stanekTM/RX_nRF24L01_Telemetry_Motor_Servo/README.md

# RC receiver (motor-servo driver, telemetry)
RC receiver with fixed RF channel and fixed address.
Telemetry sends measured voltage and "fake" RSSI (the nRF24L01+ transceiver does not contain real RSSI and is only a rough measurement of lost packets).

The hardware includes nRF24L01+ transceiver and ATmega328P processor.
The motor driver IC is based on MX1208, MX1508, MX1515, MX1616, MX1919 and others similar, which uses 4x PWM input control signals.
The option to adjust the brake is included in the code.

The firmware will be used for cars, boats, tanks, robots and aircraft.

**Works with RC transmitters:**
* [**TX_nRF24_2ch_OLED**](https://github.com/stanekTM/TX_nRF24_2ch_OLED)
* [**TX_nRF24_5ch_LED**](https://github.com/stanekTM/TX_nRF24_5ch_LED)
* [**OpenAVRc**](https://github.com/Ingwie/OpenAVRc_Dev)
* [**Multiprotocol**](https://github.com/stanekTM/TX_FW_Multi_Stanek) from my fork.

## Used libraries
* <RF24.h>      https://github.com/nRF24/RF24
* <DigitalIO.h> https://github.com/greiman/DigitalIO
* <Servo.h>     Arduino standard library

## Micro RC receiver [(motor driver, telemetry)](https://github.com/stanekTM/RX_nRF24_Motor_Servo/tree/master/RX_OAVRc_Multi_2ch_Motor)
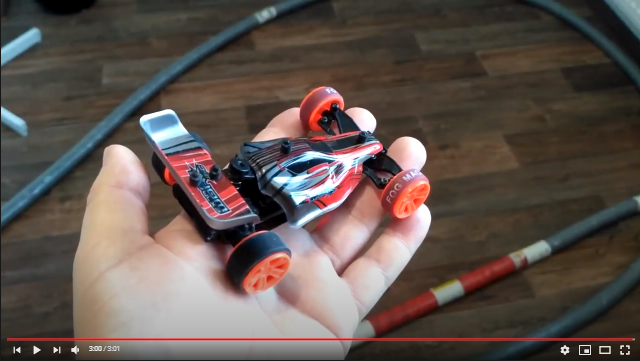
[picture p1: documents/micro_rx_youtube.PNG]


[The schematic](https://raw.githubusercontent.com/stanekTM/RX_nRF24_Motor_Servo/master/documents/micro_rx_schema.PNG) and [PCB](https://raw.githubusercontent.com/stanekTM/RX_nRF24_Motor_Servo/master/documents/micro_rx_layout.PNG) is created by a custom version of the open source [PCB Elegance](https://github.com/stanekTM/PCB_Elegance) and manufactured by [JLCPCB](https://jlcpcb.com)

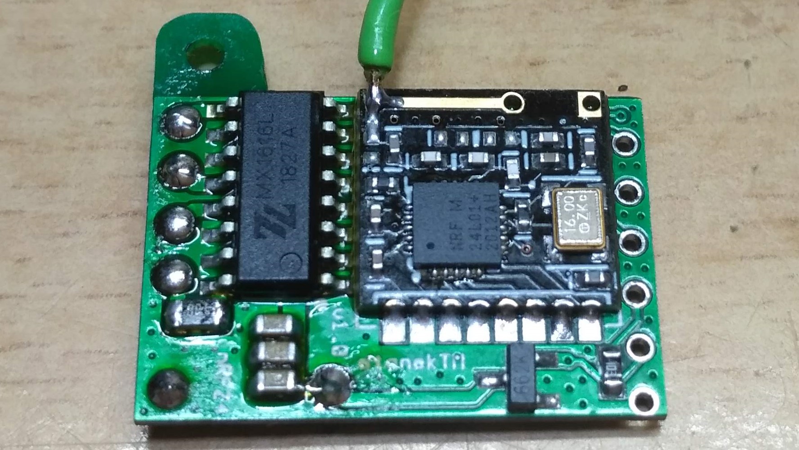
[picture p2: documents/micro_rx_1.jpg]
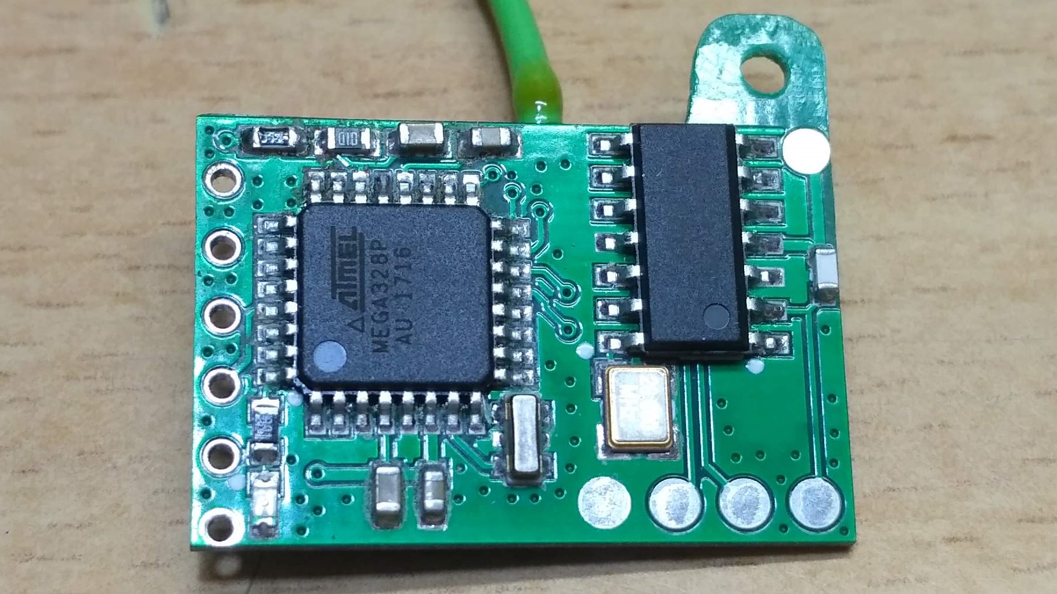
[picture p3: documents/micro_rx_2.jpg]

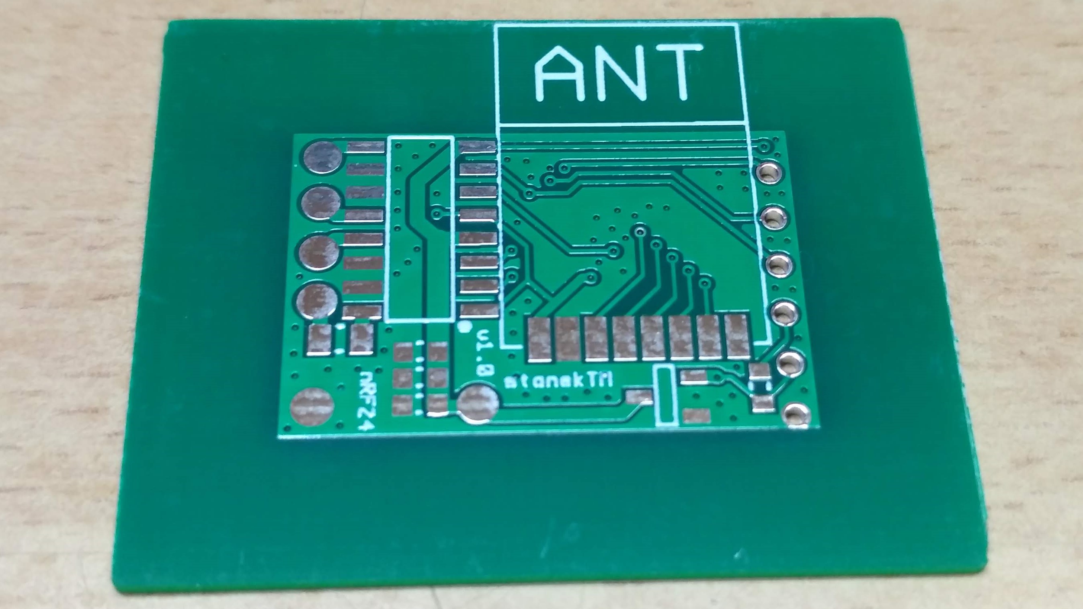
[picture p4: documents/micro_rx_3.jpg]
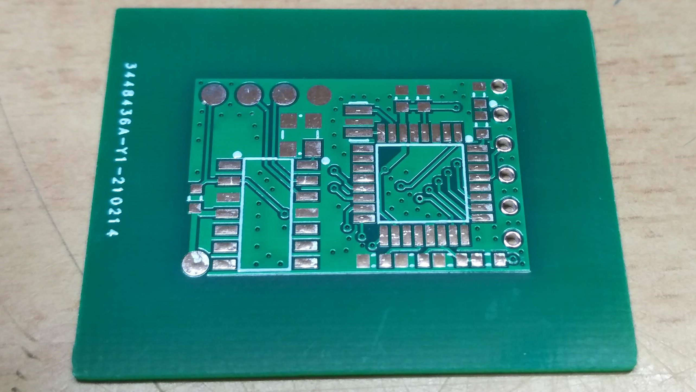
[picture p5: documents/micro_rx_4.jpg]

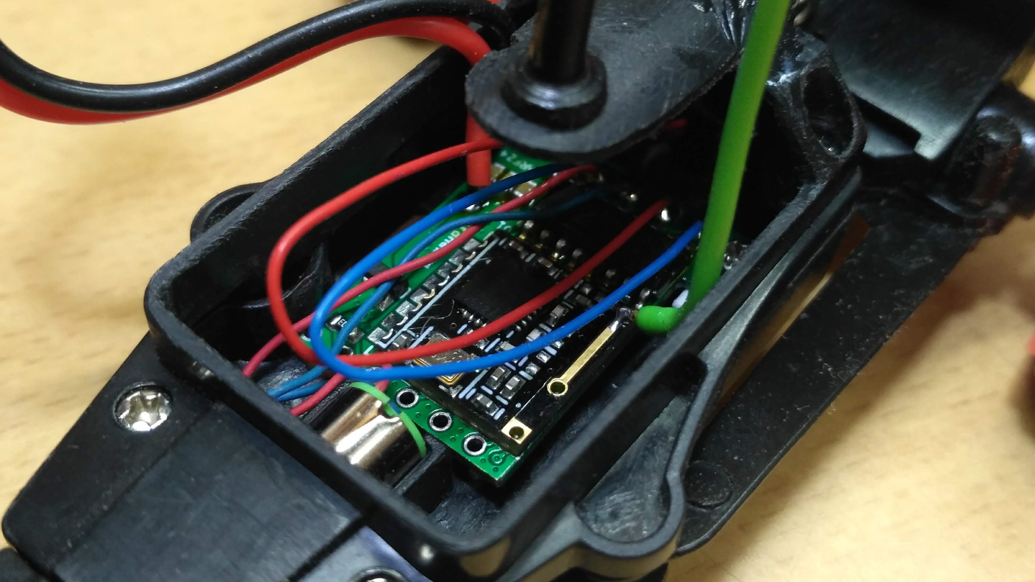
[picture p6: documents/micro_rx_5.jpg]
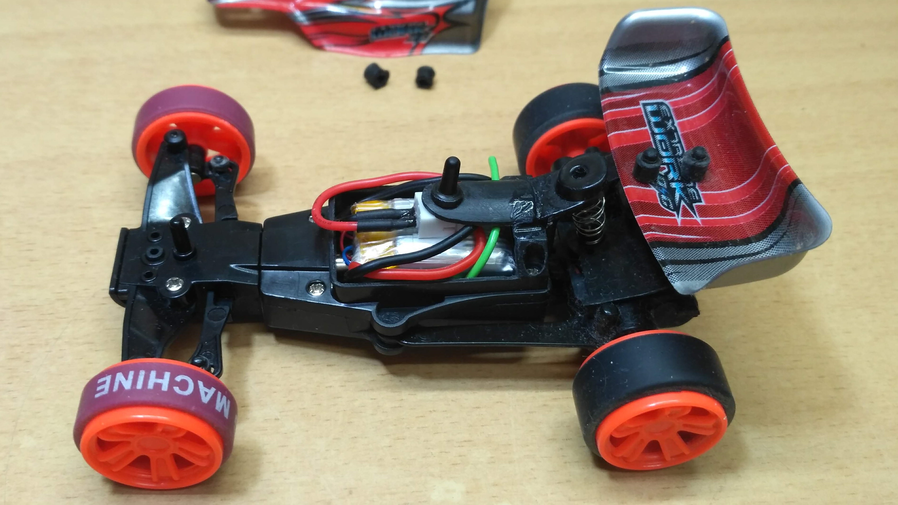
[picture p7: documents/micro_rx_6.jpg]

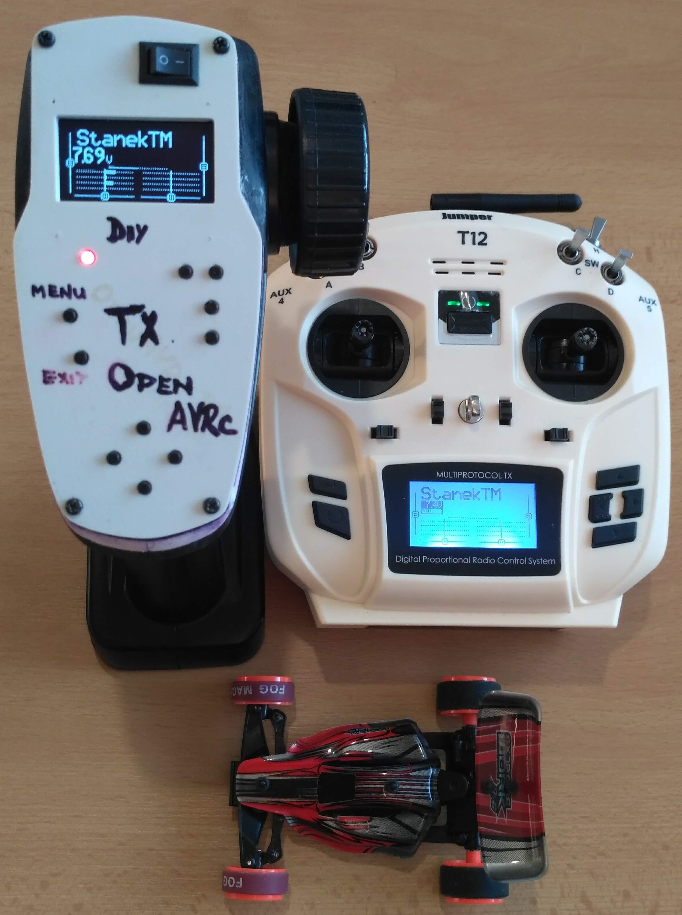
[picture p8: documents/micro_rx_7.jpg]


## RC receiver prototype [(motor-servo driver, telemetry)](https://youtu.be/jPN5YdQ-3K0?si=AT5yUzox_M3fIWEb)
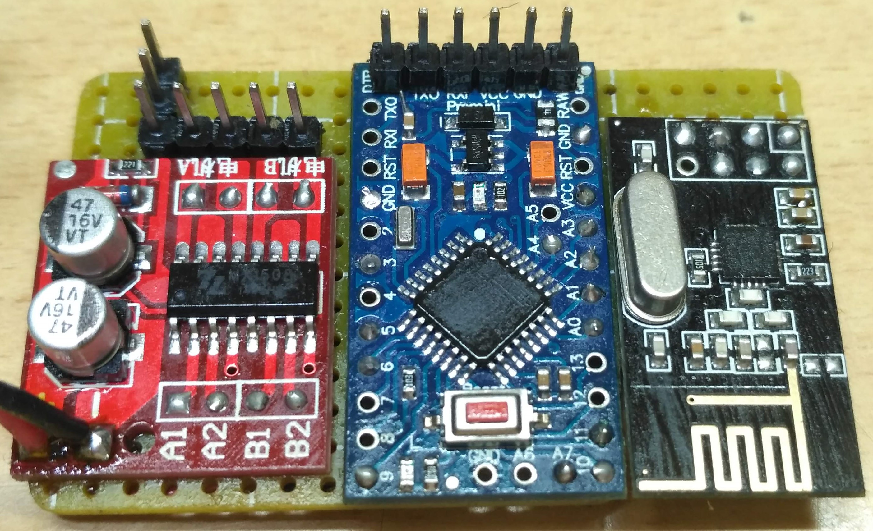
[picture p9: documents/rx_prototype_motor_servo_1.jpg]
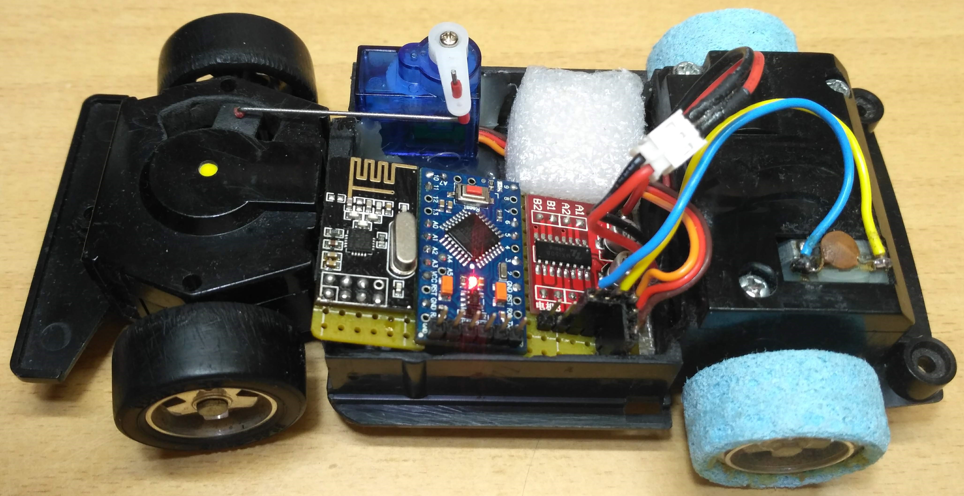
[picture p10: documents/rx_prototype_motor_servo_2.jpg]


## RC receiver prototype [(mix tank-arcade motor driver, telemetry)](https://github.com/stanekTM/RX_nRF24_Motor_Servo/tree/master/RX_nRF24_2ch_Motor_Mix_Tank)
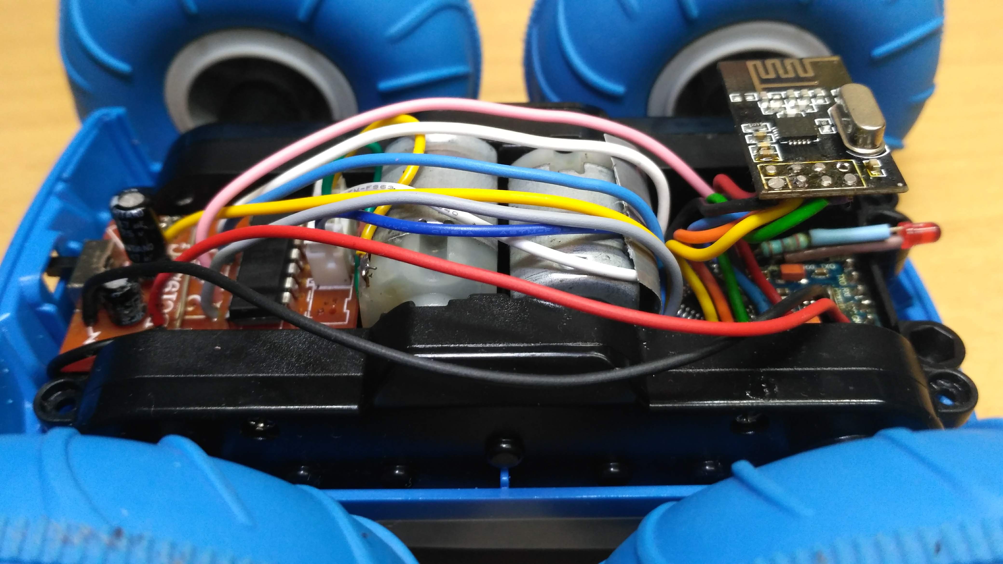
[picture p11: documents/rx_prototype_mix_tank_arcade_1.jpg]
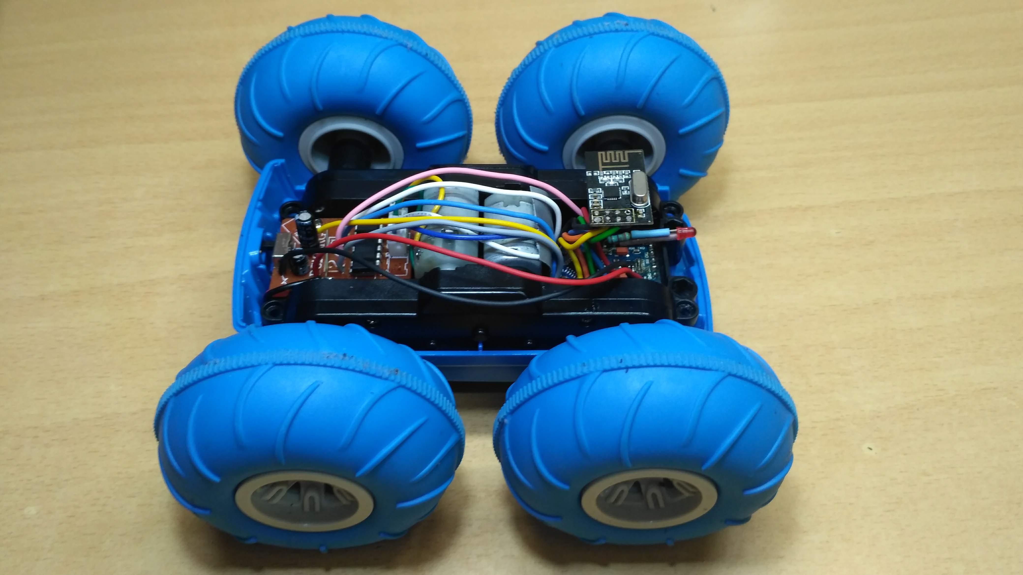
[picture p12: documents/rx_prototype_mix_tank_arcade_2.jpg]
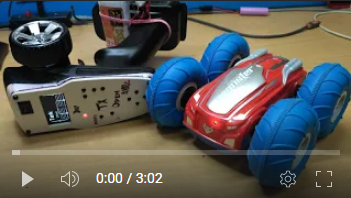
[picture p13: documents/rx_prototype_mix_tank_arcade_youtube.PNG]
