stanekTM/RX_nRF24L01_Telemetry_Motor_Servo/RX_OAVRc_Multi_2ch_Motor/README.md

# RC receiver 2ch (motor driver, telemetry)
Includes nRF24L01+ transceiver and ATmega328P processor.
The motor driver IC is based on MX1208, MX1508, MX1515, MX1616, MX1919 and others similar, which uses 4x PWM input control signals.
The option to adjust the brake is included in the code.
The PCB also includes a CMT2150A transponder for a custom RF lap reader.

The firmware will be used for cars.

Works with RC transmitters [**OpenAVRc**](https://github.com/Ingwie/OpenAVRc_Dev) or [**Multiprotocol**](https://github.com/stanekTM/TX_FW_Multi_Stanek) from my fork.

## Function
* MotorA = adjustable pwm/ch1
* MotorB = adjustable pwm/ch2
* Brake = on, off or adjustable effect 
* Normal mode = LED RX is lit
* Battery voltage 1S LiPo (4.2V) < monitored voltage = RX LED flash at a interval of 0.5s
* TX transmitter off or signal loss = RX LED flash at a interval of 0.1s 
* Fail-safe = MotorA and MotorB stopped

## Arduino pins
```
D9  - pwm1/MotorA
D10 - pwm2/MotorA
D3  - pwm3/MotorB
D11 - pwm4/MotorB

D2  - LED
A7  - telemetry analog input RX battery

nRF24L01+:
A0  - CE
A1  - CSN
software SPI:
A2  - SCK
A3  - MOSI
A4  - MISO
```

## Used libraries
* <RF24.h>      https://github.com/nRF24/RF24
* <DigitalIO.h> https://github.com/greiman/DigitalIO

## Example micro RX


The PCB is created by a custom version of the open source [PCB Elegance](https://github.com/stanekTM/PCB_Elegance) and manufactured by [JLCPCB](https://jlcpcb.com)






## An example of a tank-arcade mixer for OpenAVRc and OpenTX
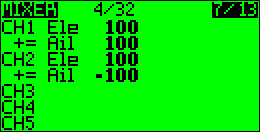
[picture p14: documents/example_mixer_1.bmp]
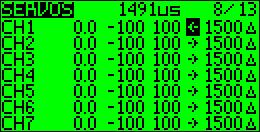
[picture p15: documents/example_mixer_2.bmp]


## Schema
The schematic is created by a custom version of the open source [PCB Elegance](https://github.com/stanekTM/PCB_Elegance)

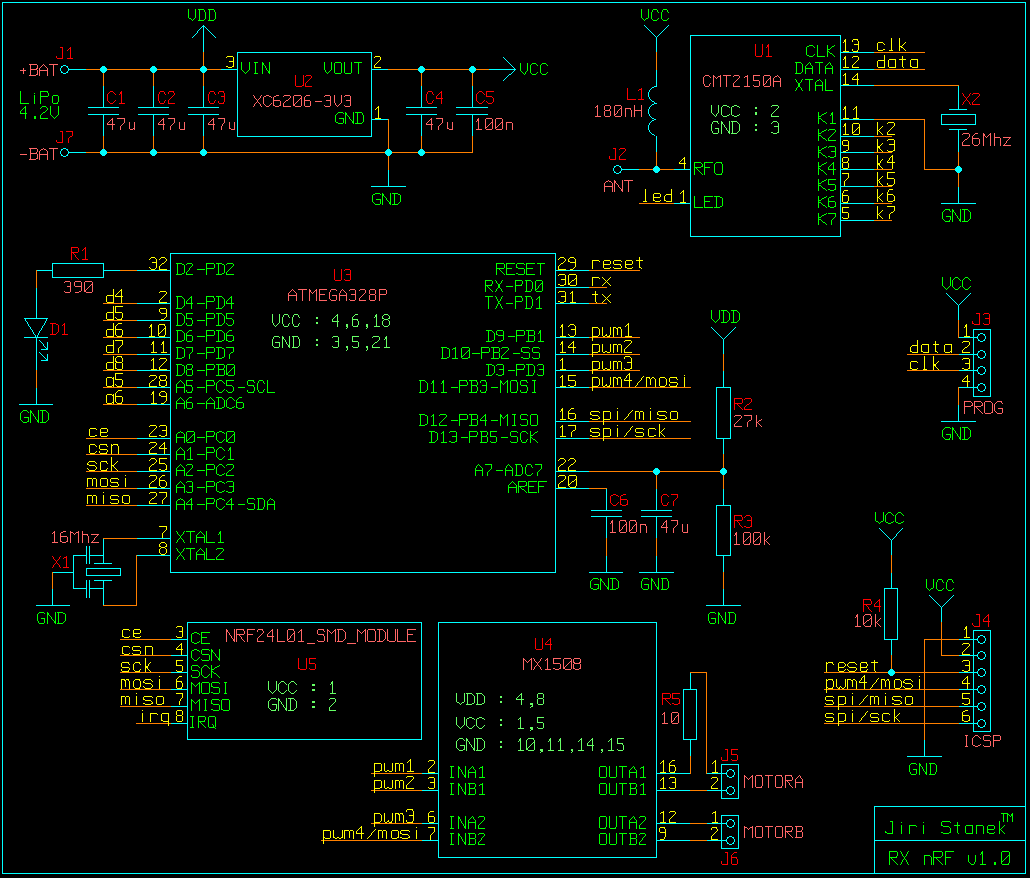
[picture p16: documents/micro_rx_schema.PNG]
schema


## Layout
The layout is created by a custom version of the open source [PCB Elegance](https://github.com/stanekTM/PCB_Elegance)

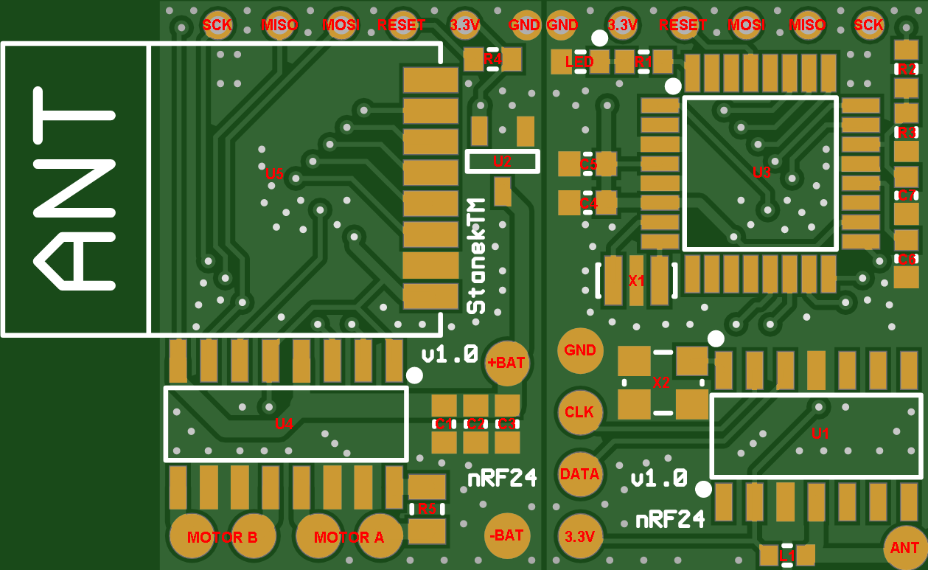
[picture p17: documents/micro_rx_layout.PNG]
layout
