stanekTM/RX_nRF24L01_Telemetry_Motor_Servo/documents/arduino_pro_mini_pinout.png

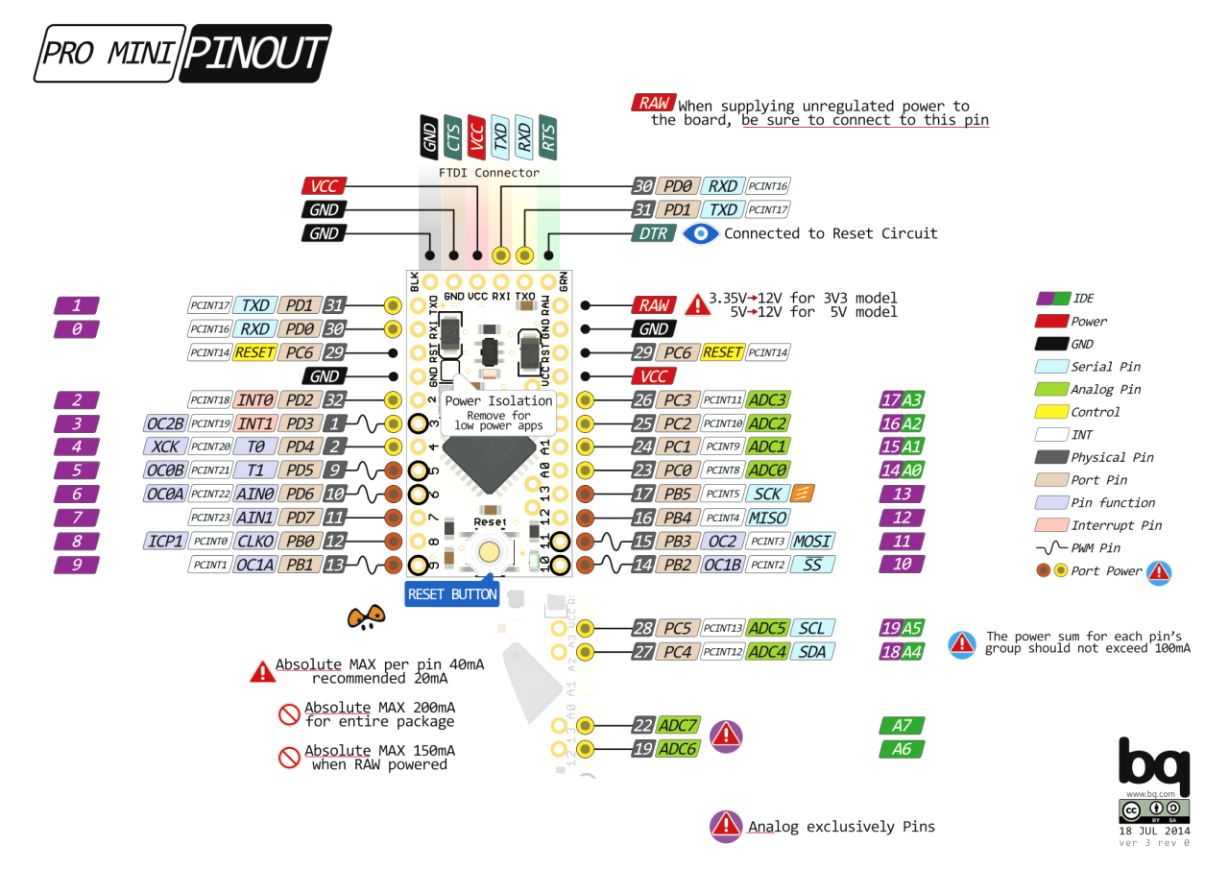
documents/arduino_pro_mini_pinout.png
