stanekTM/RX_nRF24L01_Telemetry_Motor_Servo/documents/nRF24L01_PA-LNA_external_antenna_module_pinout_top.png

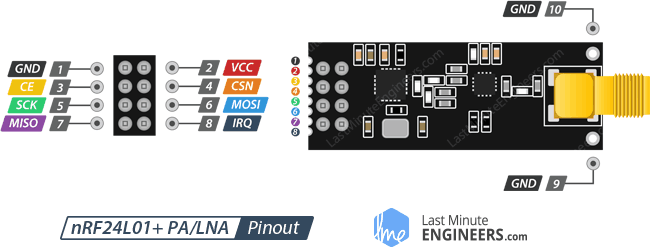
documents/nRF24L01_PA-LNA_external_antenna_module_pinout_top.png
