stanekTM/RX_nRF24L01_Telemetry_Motor_Servo/documents/nRF24L01_pcb_antenna_module_pinout_top-bottom.png

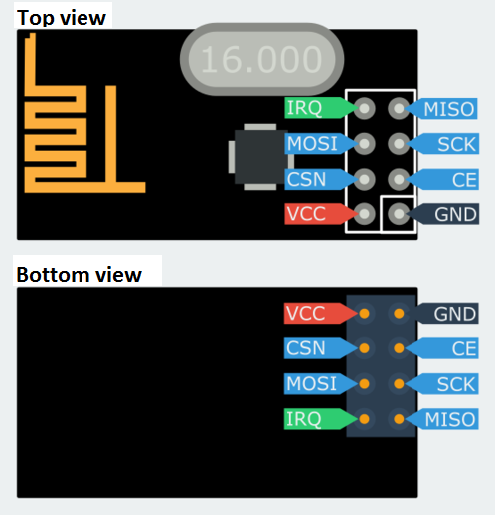
documents/nRF24L01_pcb_antenna_module_pinout_top-bottom.png
