stanekTM/RX_nRF24L01_Telemetry_Motor_Servo/documents/nRF24L01_smd_dimensions.PNG

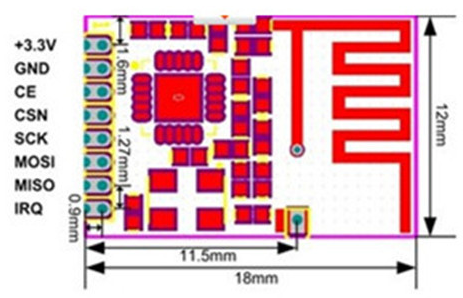
documents/nRF24L01_smd_dimensions.PNG
