stanekTM/RX_nRF24L01_Telemetry_Motor_Servo/documents/nRF24L01_smd_pinout_bottom.jpg

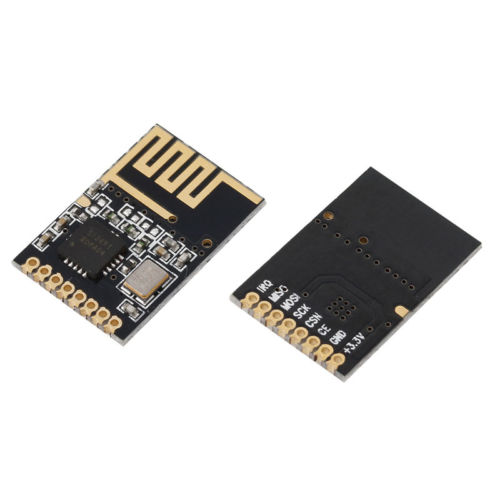
documents/nRF24L01_smd_pinout_bottom.jpg
