stanekTM/RX_nRF24L01_Telemetry_Motor_Servo/RC_RX_nRF24L01_2ch_A1_Motor_Driver/RC_RX_nRF24L01_2ch_A1_Motor_Driver.ino

//***************************************************************************************************
//Communication nRF24L01P. Fixed RF channel, fixed address.                                         *
//Support for TX Telemetry LCD transmitter https://github.com/stanekTM/RC_TX_nRF24L01_Telemetry_LCD *
//and for the TX Telemetry LED transmitter https://github.com/stanekTM/RC_TX_nRF24L01_Telemetry_LED *
//***************************************************************************************************

#include <RF24.h>         //https://github.com/nRF24/RF24 v1.3.9
//#include <printf.h>       //print the radio debug info
#include <DigitalIO.h>    //https://github.com/greiman/DigitalIO
#include "PWMFrequency.h" //used locally https://github.com/TheDIYGuy999/PWMFrequency


//setting RF channels address (5 bytes number or character)
const byte address[] = "jirka";

//RF communication channel settings (0-125, 2.4Ghz + 76 = 2.476Ghz)
#define radio_channel 76

//settings PWM MotorA (pin D9 or D10)
//1024 = 30Hz, 256 = 122Hz, 64 = 488Hz(default), 8 = 3906Hz
#define pwm_motorA 256

//settings PWM MotorB (pin D3 or D11)
//1024 = 30Hz, 256 = 122Hz, 128 = 244Hz, 64 = 488Hz(default), 32 = 976Hz, 8 = 3906Hz
#define pwm_motorB 256

//setting the reaction of the motor to be rotated after the lever has been moved
#define accelerate_motorA 40
#define accelerate_motorB 40

//Brake setting, adjustment (0-255), no brake 0, max brake 255
#define brake_motorA 255
#define brake_motorB 0

//LED alarm battery voltage setting
#define battery_voltage   4.2
#define monitored_voltage 3.35

//setting the dead zone of poor quality joysticks TX for the motor controller
#define dead_zone  15

//PPM settings
#define servoMid   1500
#define servoMin   1000
#define servoMax   2000

//free pins
//pin              0
//pin              1
//pin              4
//pin              5
//pin              6
//pin              7
//pin              8
//pin              12 //MISO
//pin              13 //SCK
//pin              A5
//pin              A6
 
//pwm pins for motor
#define pin_pwm1_motorA 9
#define pin_pwm2_motorA 10
#define pin_pwm3_motorB 3
#define pin_pwm4_motorB 11 //MOSI

//LED RX battery and RF on/off
#define pin_LED    2

//input RX battery
#define pin_RXbatt A7

//pins for nRF24L01
#define pin_CE     A0
#define pin_CSN    A1

//software SPI http://tmrh20.github.io/RF24/Arduino.html
//----- SCK   16 - A2
//----- MOSI  17 - A3
//----- MISO  18 - A4

//setting of CE and CSN pins
RF24 radio(pin_CE, pin_CSN);

//************************************************************************************************************************************************************************
//this structure defines the received data in bytes (structure size max. 32 bytes) ***************************************************************************************
//************************************************************************************************************************************************************************
struct packet
{
  unsigned int ch1; //MotorA
  unsigned int ch2; //MotorB
  unsigned int ch3; //unused channel, only adding byte array TX 5ch
  unsigned int ch4; //unused channel, only adding byte array TX 5ch
  unsigned int ch5; //unused channel, only adding byte array TX 5ch
};
packet rc_data; //create a variable with the above structure

//************************************************************************************************************************************************************************
//this struct defines data, which are embedded inside the ACK payload ****************************************************************************************************
//************************************************************************************************************************************************************************
struct ackPayload
{
  float RXbatt;
};
ackPayload payload;

//************************************************************************************************************************************************************************
//reset values (servoMin = 1000us, servoMid = 1500us, servoMax = 2000us) *************************************************************************************************
//************************************************************************************************************************************************************************
void resetData()
{
  rc_data.ch1 = servoMid; //MotorA
  rc_data.ch2 = servoMid; //MotorB
}

//************************************************************************************************************************************************************************
//setup frequencies and motors control ***********************************************************************************************************************************
//************************************************************************************************************************************************************************
int value_motorA = 0, value_motorB = 0;

void outputPWM()
{  
/*
 * The base frequency for pins 3, 9, 10, 11 is 31250Hz.
 * The base frequency for pins 5, 6         is 62500Hz.
 * 
 * The divisors available on pins 5, 6, 9, 10 are: 1, 8, 64, 256, and 1024.
 * The divisors available on pins 3, 11       are: 1, 8, 32, 64, 128, 256, and 1024.
 * 
 * Pins 5, 6  are paired on timer0, functions delay(), millis(), micros() and delayMicroseconds()
 * D5   pwm 976Hz(default), timer0, 8-bit
 * D6   pwm 976Hz(default), timer0, 8-bit
 * 
 * Pins 9, 10 are paired on timer1, Servo library
 * D9   pwm 488Hz(default), timer1, 16-bit
 * D10  pwm 488Hz(default), timer1, 16-bit
 * 
 * Pins 3, 11 are paired on timer2, ServoTimer2 library
 * D3   pwm 488Hz(default), timer2, 8-bit
 * D11  pwm 488Hz(default), timer2, 8-bit, SPI MOSI hardware
*/

//MotorA PWM frequency pin D9 or pin D10
//1024 = 30Hz, 256 = 122Hz, 64 = 488Hz(default), 8 = 3906Hz
  setPWMPrescaler(pin_pwm1_motorA, pwm_motorA);  

//MotorB PWM frequency pin D3 or pin D11
//1024 = 30Hz, 256 = 122Hz, 128 = 244Hz, 64 = 488Hz(default), 32 = 976Hz, 8 = 3906Hz
  setPWMPrescaler(pin_pwm3_motorB, pwm_motorB);

//MotorA -------------------------------------------------------------------------------------

  if (rc_data.ch1 < servoMid - dead_zone)
  {
    value_motorA = map(rc_data.ch1, servoMid - dead_zone, servoMin, accelerate_motorA, 255);
    analogWrite(pin_pwm1_motorA, value_motorA);
    digitalWrite(pin_pwm2_motorA, LOW);
  }
  else if (rc_data.ch1 > servoMid + dead_zone)
  {
    value_motorA = map(rc_data.ch1, servoMid + dead_zone, servoMax, accelerate_motorA, 255);
    analogWrite(pin_pwm2_motorA, value_motorA); 
    digitalWrite(pin_pwm1_motorA, LOW);
  }
  else
  {
    analogWrite(pin_pwm1_motorA, brake_motorA);
    analogWrite(pin_pwm2_motorA, brake_motorA);
  }

//  Serial.println(rc_data.ch1); //print value on a serial monitor
  
//MotorB -------------------------------------------------------------------------------------

  if (rc_data.ch2 < servoMid - dead_zone)
  {
    value_motorB = map(rc_data.ch2, servoMid - dead_zone, servoMin, accelerate_motorB, 255);
    analogWrite(pin_pwm3_motorB, value_motorB);
    digitalWrite(pin_pwm4_motorB, LOW);
  }
  else if (rc_data.ch2 > servoMid + dead_zone)
  {
    value_motorB = map(rc_data.ch2, servoMid + dead_zone, servoMax, accelerate_motorB, 255);
    analogWrite(pin_pwm4_motorB, value_motorB);
    digitalWrite(pin_pwm3_motorB, LOW);
  }
  else
  {
    analogWrite(pin_pwm3_motorB, brake_motorB);
    analogWrite(pin_pwm4_motorB, brake_motorB);
  }
}

//************************************************************************************************************************************************************************
//initial main settings **************************************************************************************************************************************************
//************************************************************************************************************************************************************************
uint8_t invert_address = ~address[5]; //Invert bits for writing so that telemetry packets have a different address

void setup()
{
//  Serial.begin(9600); //print value on a serial monitor
//  printf_begin();     //print the radio debug info

  pinMode(pin_pwm1_motorA, OUTPUT);
  pinMode(pin_pwm2_motorA, OUTPUT);
  pinMode(pin_pwm3_motorB, OUTPUT);
  pinMode(pin_pwm4_motorB, OUTPUT);
  
  pinMode(pin_LED, OUTPUT);
  pinMode(pin_RXbatt, INPUT);
  
  resetData();

  //define the radio communication
  radio.begin();  
  radio.setAutoAck(true);          //ensure autoACK is enabled (default true)
  radio.enableAckPayload();        //enable Ack dynamic payloads. This only works on pipes 0&1 by default
  radio.enableDynamicPayloads();   //enable dynamic payloads on all pipes

//  radio.enableDynamicAck();
//  radio.setPayloadSize(10);        //set static payload size. Default max. 32 bytes
//  radio.setCRCLength(RF24_CRC_16); //RF24_CRC_8, RF24_CRC_16
//  radio.setAddressWidth(5);        //the address width in bytes 3, 4 or 5 (24, 32 or 40 bit)

  radio.setRetries(5, 5);          //set the number and delay of retries on failed submit (max. 15 x 250us delay (blocking !), max. 15 retries)
  
  radio.setChannel(radio_channel); //which RF channel to communicate on (0-125, 2.4Ghz + 76 = 2.476Ghz)
  radio.setDataRate(RF24_250KBPS); //RF24_250KBPS (fails for units without +), RF24_1MBPS, RF24_2MBPS
  radio.setPALevel(RF24_PA_MIN);   //RF24_PA_MIN (-18dBm), RF24_PA_LOW (-12dBm), RF24_PA_HIGH (-6dbm), RF24_PA_MAX (0dBm) 

  radio.openWritingPipe(invert_address); //open the writing pipe0 (RX_ADDR_P0 + TX_ADDR)
  radio.openReadingPipe(1, address);     //open the reading pipe1 (RX_ADDR_P1) and then call "startListening"
                                          
  radio.startListening(); //set the module as receiver. Start listening on the pipes opened for reading
}

//************************************************************************************************************************************************************************
//program loop ***********************************************************************************************************************************************************
//************************************************************************************************************************************************************************
void loop()
{
  receive_time();
  send_and_receive_data();

  outputPWM();

//  Serial.println("Radio details *****************");
//  radio.printDetails(); //print the radio debug info
 
}

//************************************************************************************************************************************************************************
//get time after losing RF data or turning off the TX, reset data and the LED flashing ***********************************************************************************
//************************************************************************************************************************************************************************
unsigned long lastRxTime = 0;

void receive_time()
{
  if(millis() >= lastRxTime + 1000) //1s
  {
    resetData();
    RFoff_check();
  }
}

//************************************************************************************************************************************************************************
//send and receive data **************************************************************************************************************************************************
//************************************************************************************************************************************************************************
void send_and_receive_data()
{
  byte pipeNo;
  
  if (radio.available(&pipeNo))
  {
    radio.writeAckPayload(pipeNo, &payload, sizeof(ackPayload));
   
    radio.read(&rc_data, sizeof(packet));
    
    lastRxTime = millis(); //at this moment we have received the data
    RX_batt_check();
  } 
}

//************************************************************************************************************************************************************************
//reading adc RX battery. After receiving RF data, the monitored RX battery is activated *********************************************************************************
//when RX battery_voltage < monitored_voltage = LED alarm RX flash at a interval of 0.5s. Battery OK = LED RX is lit *****************************************************
//************************************************************************************************************************************************************************
unsigned long ledTime = 0, adcTime = 0;
int ledState, detect;

void RX_batt_check()
{
  if (millis() >= adcTime + 1000) //delay adc reading RX battery
  {
    adcTime = millis();

    payload.RXbatt = analogRead(pin_RXbatt) * (battery_voltage / 1023);
  }

  detect = payload.RXbatt <= monitored_voltage;
  
  if (millis() >= ledTime + 500)
  {
    ledTime = millis();
    
    if (ledState >= !detect + HIGH)
    {
      ledState = LOW;
    }
    else
    {
      ledState = HIGH;
    }   
    digitalWrite(pin_LED, ledState);
  }
//  Serial.println(payload.RXbatt); //print value on a serial monitor
}

//************************************************************************************************************************************************************************
//when RX is switched on and TX is switched off, or after the loss of RF data = LED RX flash at a interval of 0.1s. Normal mode = LED RX is lit **************************
//************************************************************************************************************************************************************************
void RFoff_check()
{
  if (millis() >= ledTime + 100)
  {
    ledTime = millis();
    
    if (ledState)
    {
      ledState = LOW;
    }
    else
    {
      ledState = HIGH;
    }   
    digitalWrite(pin_LED, ledState);
  }
}
 
