stanekTM/RX_nRF24L01_Telemetry_Motor_Servo/(commit log)

2020-07-01 LED signaling of the presence of RF signal
2020-07-29 RX undervoltage detection and RF data loss by LED flashing indication
2021-01-12 added filtering, smoothing input adc reading RX battery by calculating moving average
    added filtering, smoothing input adc reading RX battery by calculating moving average
2021-02-12 add gerber
2021-02-14 Create nRF24L01 pinout pcb antenna module.png
2021-02-14 Create nRF24L01 pinout PA-LNA internal smd antenna module.jpg
2021-02-14 Create nRF24L01 pinout PA-LNA external antenna module.png
2021-02-16 add gerber and layout
2021-02-23 delay adc reading RX battery
2022-04-02 setting the maximum motor power.
    setting the maximum motor power. Suitable for TX transmitters without endpoint setting (0-255)
2022-04-13 rename files to shorter names
    [PWMFrequency.h]
2022-04-14 add PWM pins description
2022-04-25 settings PWM
2022-08-07 fix link to soft SPI
2022-08-18 add fw mix tank, arcade driver
2022-08-19 add fw tank-arcade motor driver
2022-08-22 Create arduino pro mini pinout.png
2022-08-27 full brake
2022-09-20 change to Arduino variables
2022-10-20 fix "radio available" which caused newer libraries from v1.3.10 to current to not work
2022-12-18 just better millis :)
2023-01-01 it is now possible to preview functions in the Arduino IDE 2.0
2023-05-08 Setting any motor power in both directions. Suitable, for example, when reversing, when maximum engine power is not needed.
2023-08-02 low battery detection
    will flash until reboot
2023-10-27 better flashing LED
